jabadiagm/MSXmapper_tn9k/README.md

# MSXmapper_tn9k
Mapper de 4 MB para MSX

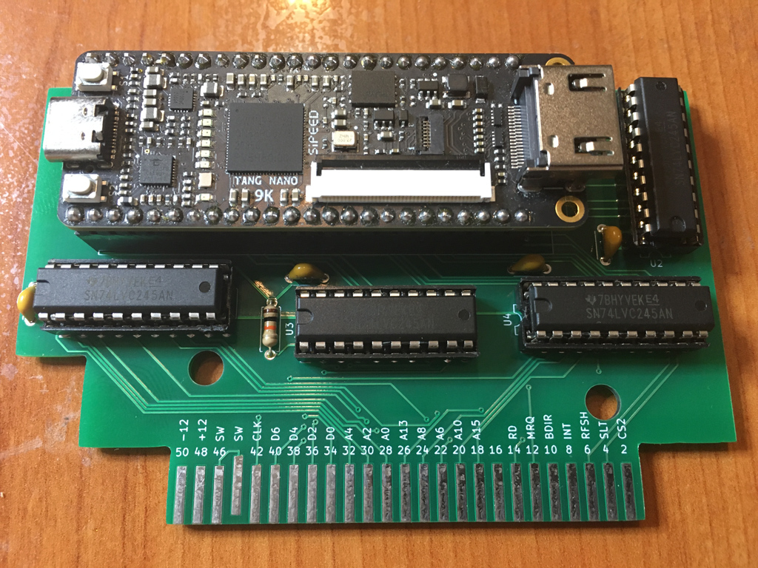
[picture p1: pantallazo.jpg]
pantallazo


Mapper de 4MB utilizando uno de los bancos de memoria PSRAM de la tang nano 9k. Compatible con dispositivos con un reloj de hasta 4.8 MHz.
