jabadiagm/MSXmapper_tn9k/fpga/clock.png

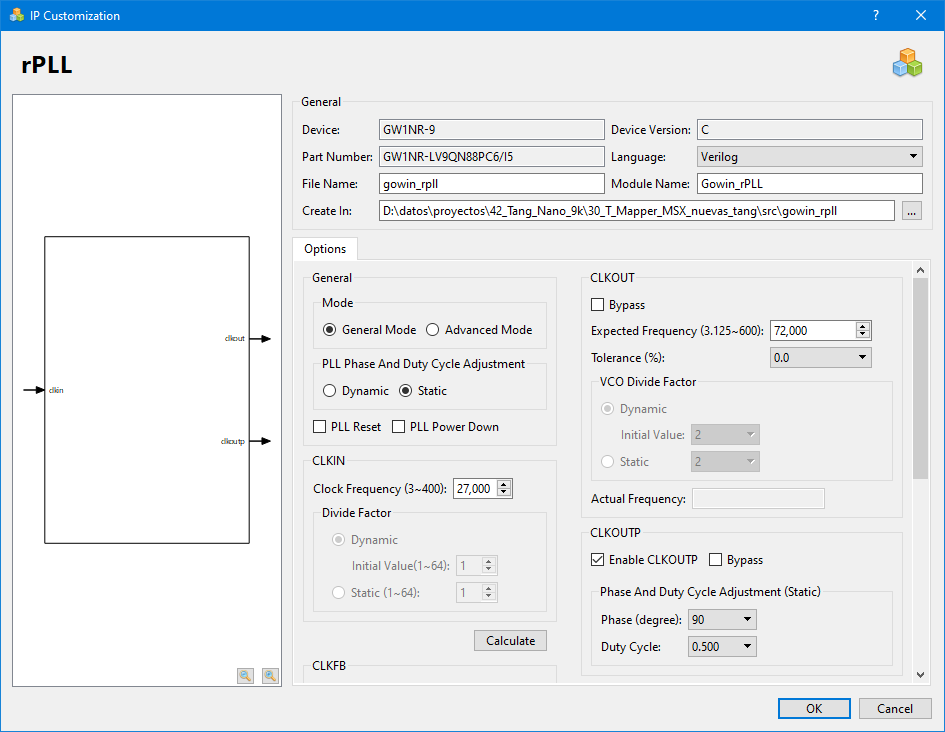
fpga/clock.png
