jabadiagm/MSXmapper_tn9k/kicad/t_mapper.kicad_pcb

## KiCad design kicad/t_mapper.kicad_pcb (2023-06-25)

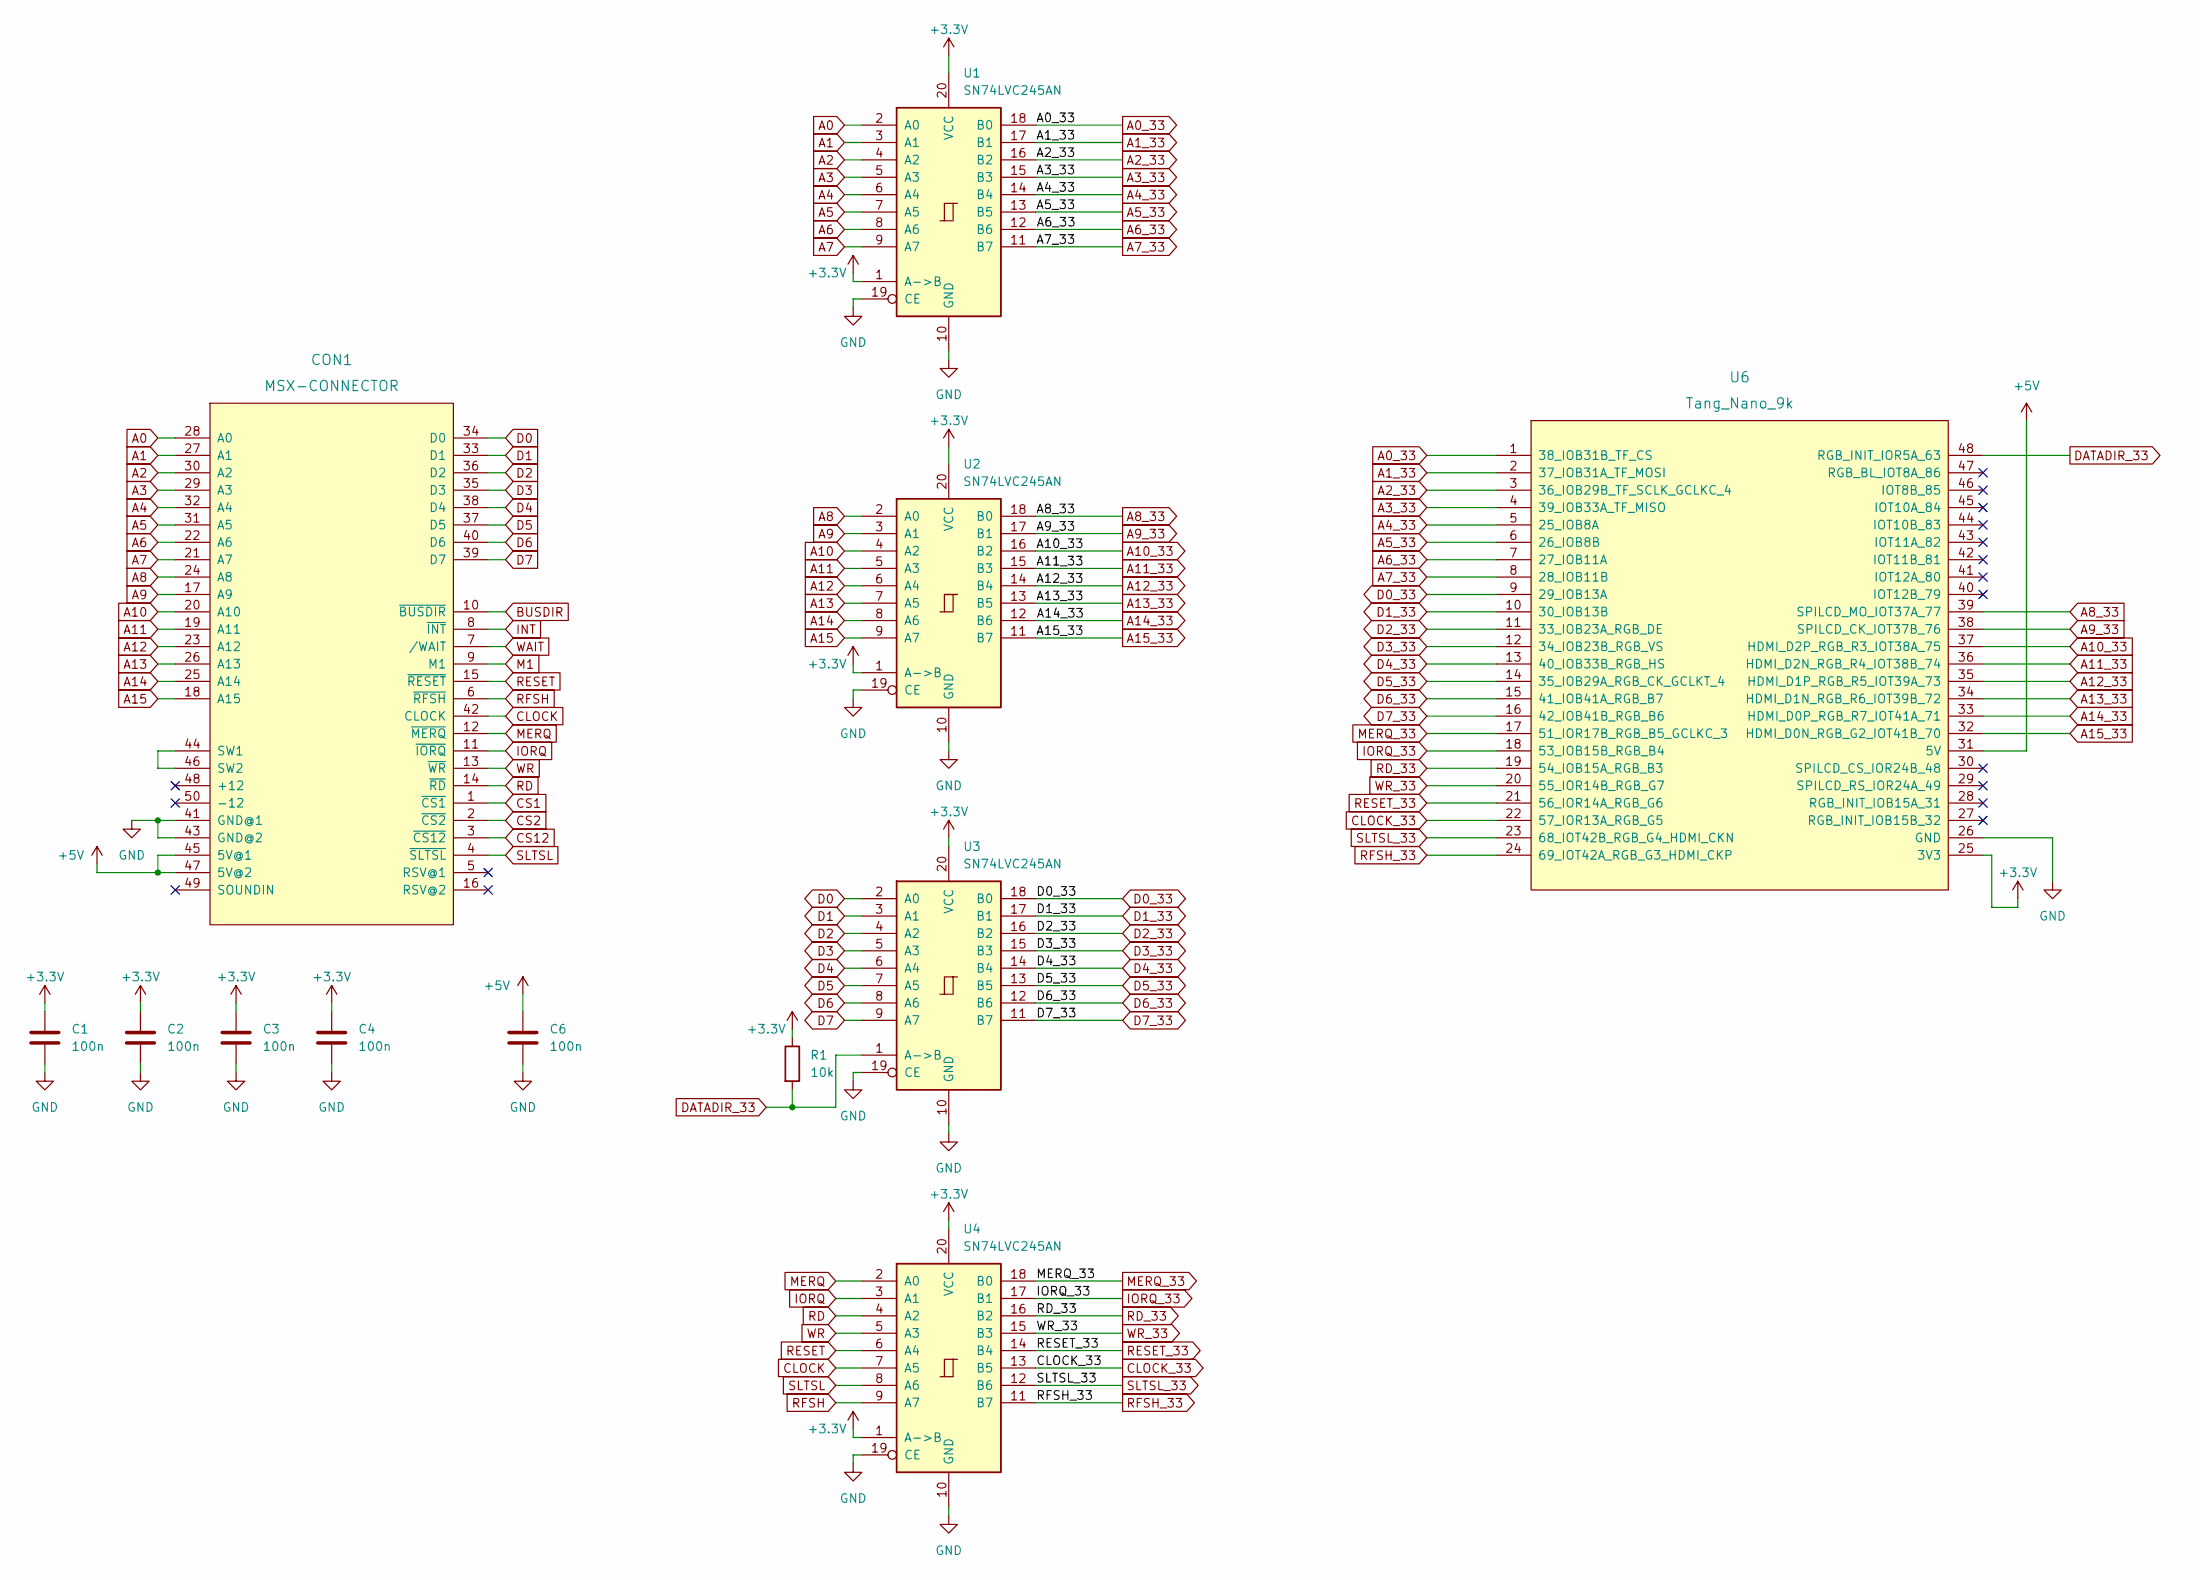
[picture p3: schematic t_mapper.kicad_sch, MSX-Tang Nano 9K Breakout]

Parts:
C1, C2, C3, C4, C6: 100n; C_Disc_D4.3mm_W1.9mm_P5.00mm
CON1: MSX-CONNECTOR; CARTRIDGE_MSX
R1: 10k; R_Axial_DIN0207_L6.3mm_D2.5mm_P7.62mm_Horizontal
U1, U2, U3, U4: SN74LVC245AN; DIP-20_W7.62mm_LongPads
U6: Tang_Nano_9k

Connections:
+3.3V: C1.1, C2.1, C3.1, C4.1, R1.1, U1.1 (A->B), U1.20 (VCC), U2.1 (A->B), U2.20 (VCC), U3.20 (VCC), U4.1 (A->B), U4.20 (VCC), U6.25 (3V3)
+5V: C6.1, CON1.45 (5V@1), CON1.47 (5V@2), U6.31 (5V)
A0: CON1.28 (A0), U1.2 (A0)
A0_33: U1.18 (B0), U6.1 (38_IOB31B_TF_CS)
A1: CON1.27 (A1), U1.3 (A1)
A1_33: U1.17 (B1), U6.2 (37_IOB31A_TF_MOSI)
A2: CON1.30 (A2), U1.4 (A2)
A2_33: U1.16 (B2), U6.3 (36_IOB29B_TF_SCLK_GCLKC_4)
A3: CON1.29 (A3), U1.5 (A3)
A3_33: U1.15 (B3), U6.4 (39_IOB33A_TF_MISO)
A4: CON1.32 (A4), U1.6 (A4)
A4_33: U1.14 (B4), U6.5 (25_IOB8A)
A5: CON1.31 (A5), U1.7 (A5)
A5_33: U1.13 (B5), U6.6 (26_IOB8B)
A6: CON1.22 (A6), U1.8 (A6)
A6_33: U1.12 (B6), U6.7 (27_IOB11A)
A7: CON1.21 (A7), U1.9 (A7)
A7_33: U1.11 (B7), U6.8 (28_IOB11B)
A8: CON1.24 (A8), U2.2 (A0)
A8_33: U2.18 (B0), U6.39 (SPILCD_MO_IOT37A_77)
A9: CON1.17 (A9), U2.3 (A1)
A9_33: U2.17 (B1), U6.38 (SPILCD_CK_IOT37B_76)
A10: CON1.20 (A10), U2.4 (A2)
A10_33: U2.16 (B2), U6.37 (HDMI_D2P_RGB_R3_IOT38A_75)
A11: CON1.19 (A11), U2.5 (A3)
A11_33: U2.15 (B3), U6.36 (HDMI_D2N_RGB_R4_IOT38B_74)
A12: CON1.23 (A12), U2.6 (A4)
A12_33: U2.14 (B4), U6.35 (HDMI_D1P_RGB_R5_IOT39A_73)
A13: CON1.26 (A13), U2.7 (A5)
A13_33: U2.13 (B5), U6.34 (HDMI_D1N_RGB_R6_IOT39B_72)
A14: CON1.25 (A14), U2.8 (A6)
A14_33: U2.12 (B6), U6.33 (HDMI_D0P_RGB_R7_IOT41A_71)
A15: CON1.18 (A15), U2.9 (A7)
A15_33: U2.11 (B7), U6.32 (HDMI_D0N_RGB_G2_IOT41B_70)
BUSDIR: CON1.10 (~BUSDIR)
CLOCK: CON1.42 (CLOCK), U4.7 (A5)
CLOCK_33: U4.13 (B5), U6.22 (57_IOR13A_RGB_G5)
CS1: CON1.1 (~CS1)
CS2: CON1.2 (~CS2)
CS12: CON1.3 (~CS12)
D0: CON1.34 (D0), U3.2 (A0)
D0_33: U3.18 (B0), U6.9 (29_IOB13A)
D1: CON1.33 (D1), U3.3 (A1)
D1_33: U3.17 (B1), U6.10 (30_IOB13B)
D2: CON1.36 (D2), U3.4 (A2)
D2_33: U3.16 (B2), U6.11 (33_IOB23A_RGB_DE)
D3: CON1.35 (D3), U3.5 (A3)
D3_33: U3.15 (B3), U6.12 (34_IOB23B_RGB_VS)
D4: CON1.38 (D4), U3.6 (A4)
D4_33: U3.14 (B4), U6.13 (40_IOB33B_RGB_HS)
D5: CON1.37 (D5), U3.7 (A5)
D5_33: U3.13 (B5), U6.14 (35_IOB29A_RGB_CK_GCLKT_4)
D6: CON1.40 (D6), U3.8 (A6)
D6_33: U3.12 (B6), U6.15 (41_IOB41A_RGB_B7)
D7: CON1.39 (D7), U3.9 (A7)
D7_33: U3.11 (B7), U6.16 (42_IOB41B_RGB_B6)
DATADIR_33: R1.2, U3.1 (A->B), U6.48 (RGB_INIT_IOR5A_63)
GND: C1.2, C2.2, C3.2, C4.2, C6.2, CON1.41 (GND@1), CON1.43 (GND@2), U1.10 (GND), U1.19 (CE), U2.10 (GND), U2.19 (CE), U3.10 (GND), U3.19 (CE), U4.10 (GND), U4.19 (CE), U6.26 (GND)
INT: CON1.8 (~INT)
IORQ: CON1.11 (~IORQ), U4.3 (A1)
IORQ_33: U4.17 (B1), U6.18 (53_IOB15B_RGB_B4)
M1: CON1.9 (M1)
MERQ: CON1.12 (~MERQ), U4.2 (A0)
MERQ_33: U4.18 (B0), U6.17 (51_IOR17B_RGB_B5_GCLKC_3)
unnamed: CON1.44 (SW1), CON1.46 (SW2)
RD: CON1.14 (~RD), U4.4 (A2)
RD_33: U4.16 (B2), U6.19 (54_IOB15A_RGB_B3)
RESET: CON1.15 (~RESET), U4.6 (A4)
RESET_33: U4.14 (B4), U6.21 (56_IOR14A_RGB_G6)
RFSH: CON1.6 (~RFSH), U4.9 (A7)
RFSH_33: U4.11 (B7), U6.24 (69_IOT42A_RGB_G3_HDMI_CKP)
SLTSL: CON1.4 (~SLTSL), U4.8 (A6)
SLTSL_33: U4.12 (B6), U6.23 (68_IOT42B_RGB_G4_HDMI_CKN)
WAIT: CON1.7 (/WAIT)
WR: CON1.13 (~WR), U4.5 (A3)
WR_33: U4.15 (B3), U6.20 (55_IOR14B_RGB_G7)

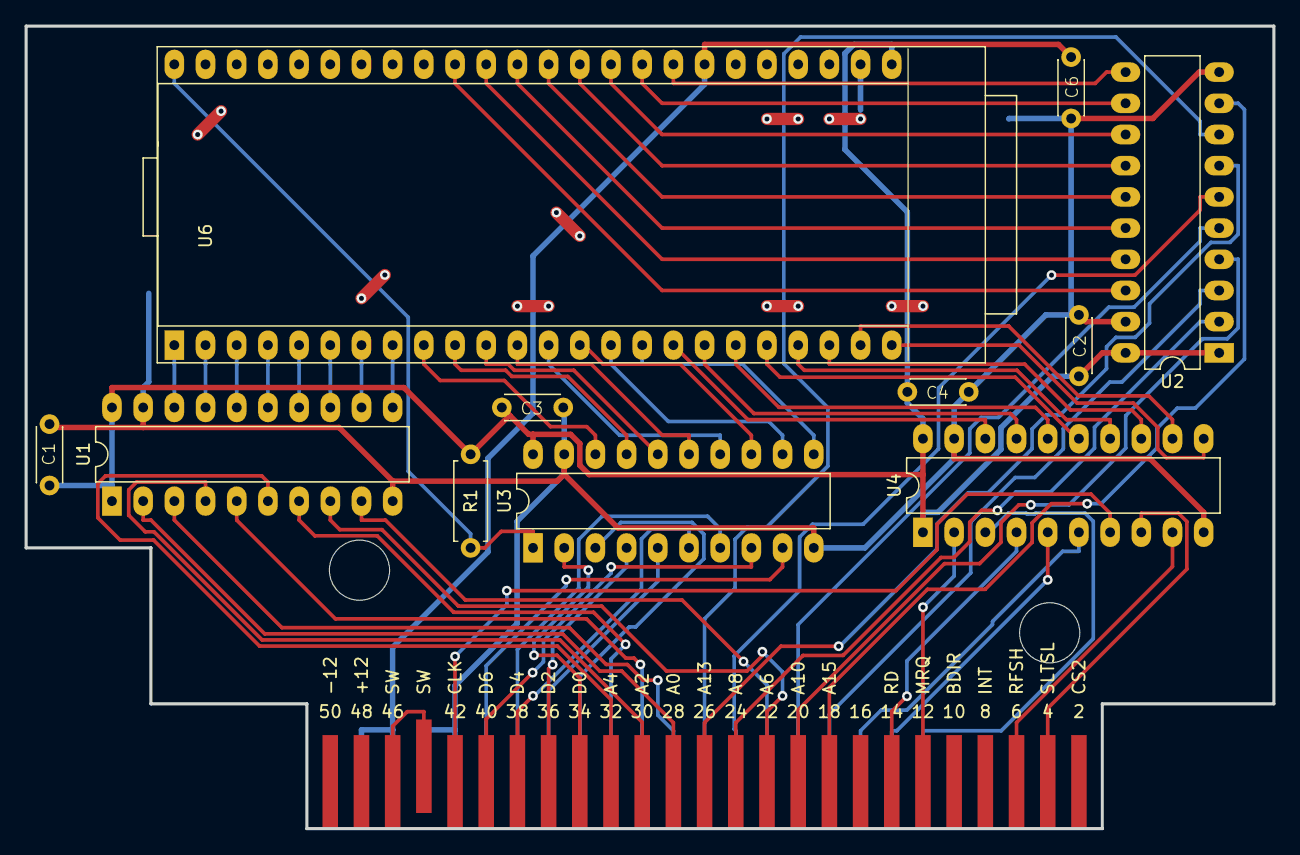
[picture p4: board t_mapper.kicad_pcb from above]

Board: 2 copper layers, 101.6 x 65.3 mm, 12 parts (0 on the bottom side), 69 nets.
