jabadiagm/MSXmapper_tn9k/fpga/src/gowin_rpll/gowin_rpll_tmp.v

//Copyright (C)2014-2022 Gowin Semiconductor Corporation.
//All rights reserved.
//File Title: Template file for instantiation
//GOWIN Version: V1.9.8.10
//Part Number: GW1NR-LV9QN88PC6/I5
//Device: GW1NR-9
//Device Version: C
//Created Time: Fri Jul 07 14:00:27 2023

//Change the instance name and port connections to the signal names
//--------Copy here to design--------

    Gowin_rPLL your_instance_name(
        .clkout(clkout_o), //output clkout
        .clkoutp(clkoutp_o), //output clkoutp
        .clkin(clkin_i) //input clkin
    );

//--------Copy end-------------------
