jabadiagm/MSXmapper_tn9k/fpga/impl/gwsynthesis/RTL_GAO/ao_0/gw_ao_expression.v

`define CORE0_DF_AO_EXPRESSION_0  match[0]|match[1]
`define CORE0_DF_AO_EXPRESSION_1  1
`define CORE0_DF_AO_EXPRESSION_2  1
`define CORE0_DF_AO_EXPRESSION_3  1
`define CORE0_DF_AO_EXPRESSION_4  1
`define CORE0_DF_AO_EXPRESSION_5  1
`define CORE0_DF_AO_EXPRESSION_6  1
`define CORE0_DF_AO_EXPRESSION_7  1
`define CORE0_DF_AO_EXPRESSION_8  1
`define CORE0_DF_AO_EXPRESSION_9  1
`define CORE0_DF_AO_EXPRESSION_10  1
`define CORE0_DF_AO_EXPRESSION_11  1
`define CORE0_DF_AO_EXPRESSION_12  1
`define CORE0_DF_AO_EXPRESSION_13  1
`define CORE0_DF_AO_EXPRESSION_14  1
`define CORE0_DF_AO_EXPRESSION_15  1
