jabadiagm/MSXmapper_tn9k/(commit log)

2023-07-15 Reducida frecuencia de trabajo de psram a 72 MHz debido a las nuevas tang nano 9k
2023-07-29 Corregido bug de dirección de bus
    ---------------------------------
    Fixed bug with busdir
    [t_mapper.v]
2023-09-03 Sincronizada escritura con reloj para gestionar tiempos del t80
    Synchronized write with clock to deal with t80 timing
